Foxkiw/TMC2026_Windscatter_research/breathing_backscatter/hardware/原理图PDF.pdf

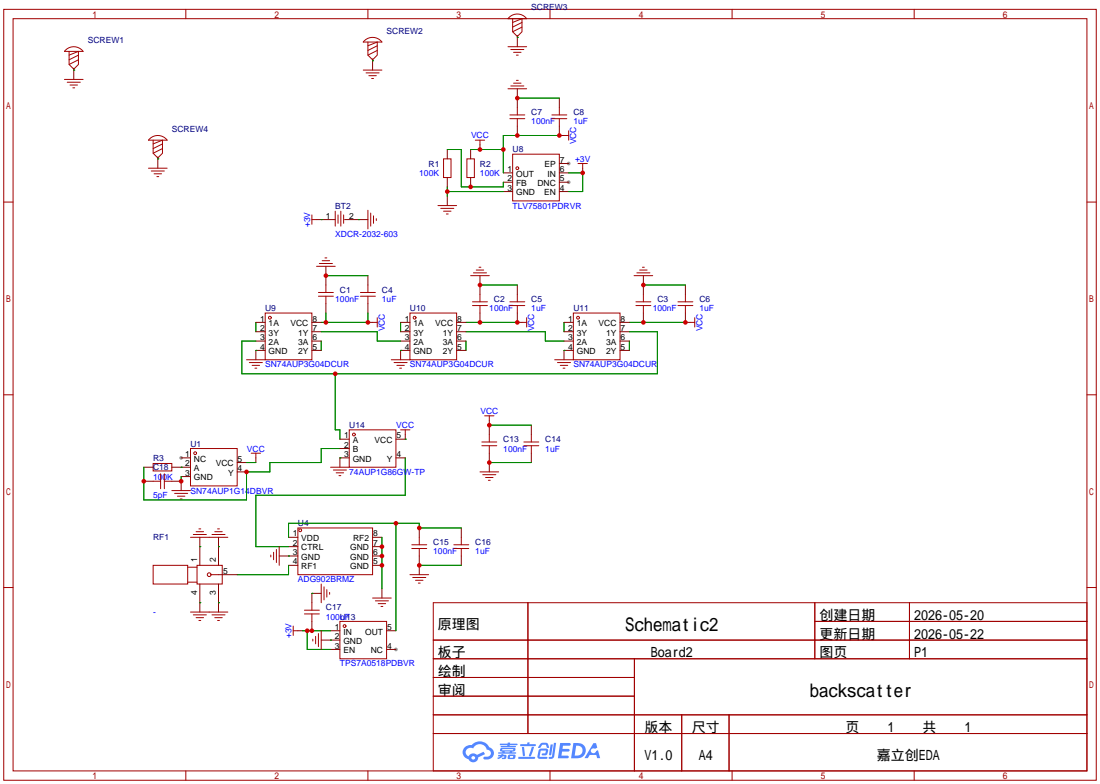
[picture p14: page 1]

原理图 | Schematic2 | 创建日期 | 2026-05-20

更新日期 | 2026-05-22

板子 | Board2 | 图页 | P1
绘制 | | backscatter
审阅

V1.0 | A4 | 嘉立创EDA
