Foxkiw/TMC2026_Windscatter_research/windscatter/hardware/原理图PDF.pdf

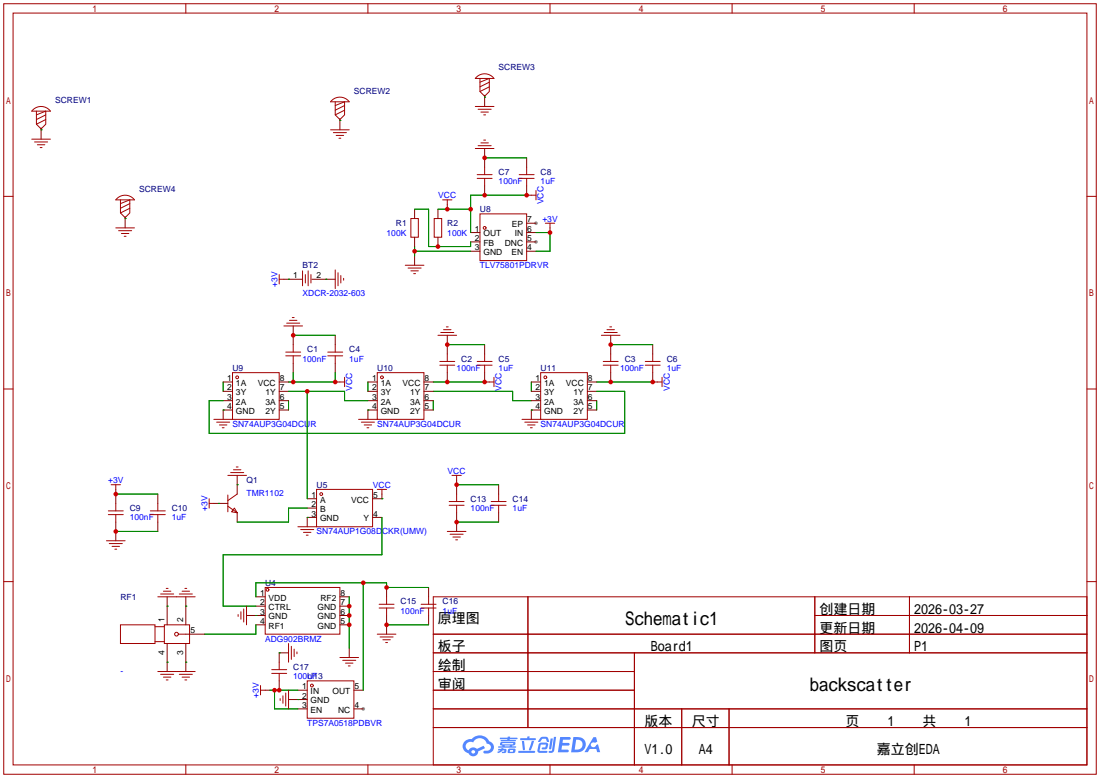
[picture p15: page 1]

C16 1uF 原理图 | Schematic1 | 创建日期 | 2026-03-27

更新日期 | 2026-04-09

板子 | Board1 | 图页 | P1
绘制 | | backscatter
审阅

V1.0 | A4 | 嘉立创EDA
