Foxkiw/TMC2026_Windscatter_research/circuit/tdo_sensor_oscillator.asc

B1: bi; I=-{G0}*(V(td)-{Vb})+{K}*(V(td)-{Vb})**3
Bcap: bi; I={dC}*sin(2*pi*{Fsense}*time)*ddt(V(osc))
C1: cap; {Csen}
C2: cap; {Cb}
L1: ind; {L}
L2: ind; {Lb}
R1: res; {Rb}
Rloss: res; {R}
V1: voltage; {Vb}
Named nets: osc, 0, td
.param Vb=120m
.param G0=1.5m
.param K=0.1
.param Lb=10u
.param Cb=1n
.param Rb=100
.param L=50.7n
.param Csen=200p
.param R=1k
.ic V(td)=120m V(osc)=1u
.tran 0 120u 0 0.2n uic
.param C0=200p
.param dC=20p
.param Fsense=20k
.meas tran Ploss AVG V(osc)*V(osc)/{R} FROM 20u TO 120u
.meas tran PRb AVG I(R1)*I(R1)*{Rb} FROM 20u TO 120u
.meas tran Pneg AVG -V(td)*I(B1) FROM 20u TO 120u
